sachismo/VideoBoy/(commit log)

2017-08-29 Added circuit board files
    [VideoBoy1.12.brd, VideoBoy1.12.sch]
2017-08-30 edited circuit drains
    [VideoBoy1.12.brd, VideoBoy1.12.sch]
